mrlsgit/electronic_crouse_design/9013 9014.docx

1、9013 结构：NPN

集电极-发射极电压 25V

集电极-基电压 45V

射极-基极电压 5V

集电极电流 0.5A

耗散功率 0.625W

结温 150℃

特怔频率最小：150MHZ

放大倍数：D64-91 E78-112 F96-135 G122-166 H144-220 I190-300

2、9014 结构：NPN

集电极-发射极电压 45V

集电极-基电压 50V

射极-基极电压 5V

集电极电流 0.1A

耗散功率 0.4W

结温 150℃

特怔频率最小：150MHZ

放大倍数：A60-150 B100-300 C200-600 D400-1000
