mrlsgit/electronic_crouse_design/电路模型.pptx

Ic

Ibe

Vs

R2

R3

rbe

βIbe

R1

## Slide 2

Ic

Ibe

Vs

R6

R4

rbe

βIbe

R5
