mrlsgit/electronic_crouse_design/设计提示.docx

https://zhidao.baidu.com/question/538384263.html
连接中有两个黄色的MIC放大电路，第一种、第二种，完成仿真，将电源电压调整为5V后，实现与3.7V类似的效果，完成实物测试；注意，扬声器不能长时间通直流电，否则会烧掉，因此第一个电路可能要稍微设计一下。MIC在multisim中可以用信号源来替代，用什么样的信号源，需要你们自己测试或者上网多了解一下MIC的真实输出
