mrlsgit/electronic_crouse_design/实验/基本电路2_无直流.docx

原电路：

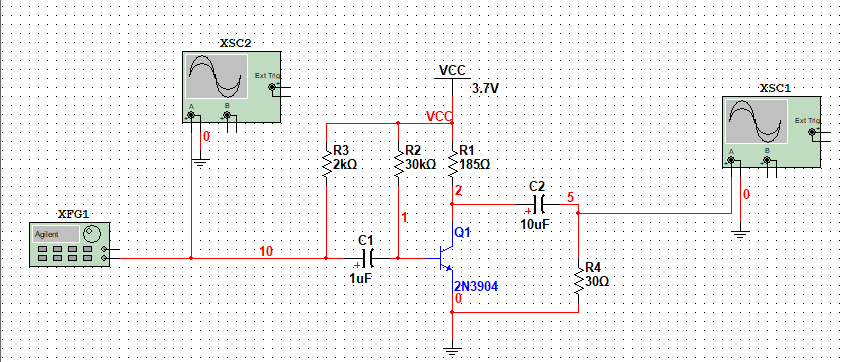
[picture p28: figure]

增压电路：

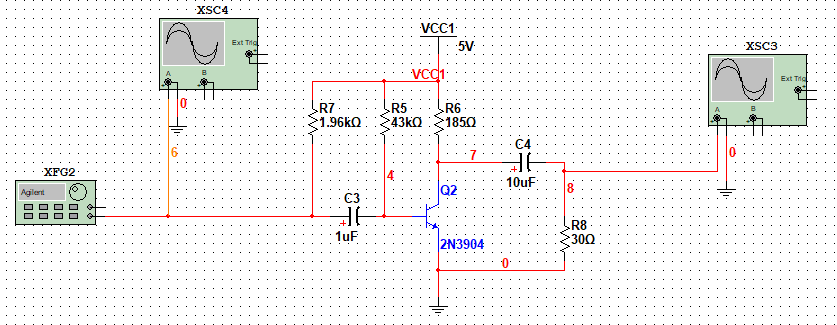
[picture p29: figure]
