mrlsgit/electronic_crouse_design/开发文档/2_见面表部分 - 副本.docx

师生见面情况记录-_1__

见面时间： 见面地点：

学生记录：

学生签名：

指导教师意见：

指导教师签名：

师生见面情况记录-___

见面时间： 见面地点：

学生记录：

学生签名：

指导教师意见：

指导教师签名：

师生见面情况记录-___

见面时间： 见面地点：

学生记录：

学生签名：

指导教师意见：

指导教师签名：

师生见面情况记录-___

见面时间： 见面地点：

学生记录：

学生签名：

指导教师意见：

指导教师签名：
