mrlsgit/electronic_crouse_design/aaa.png

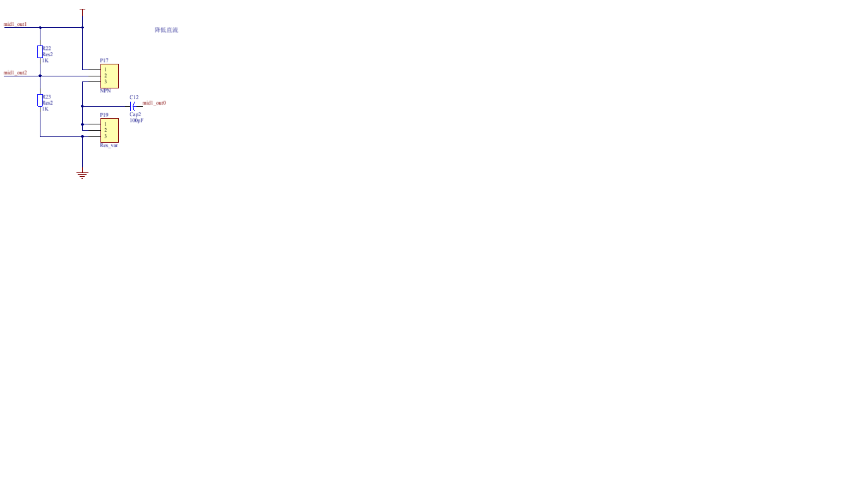
aaa.png
