mrlsgit/electronic_crouse_design/图解法.jpg

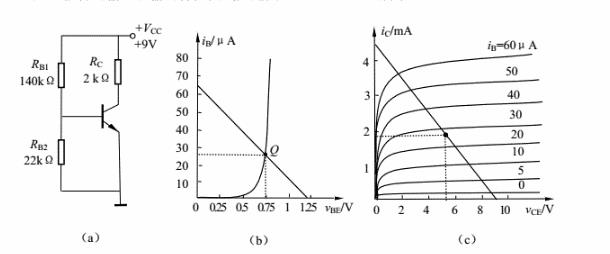
图解法.jpg
