mrlsgit/electronic_crouse_design/放大区.png

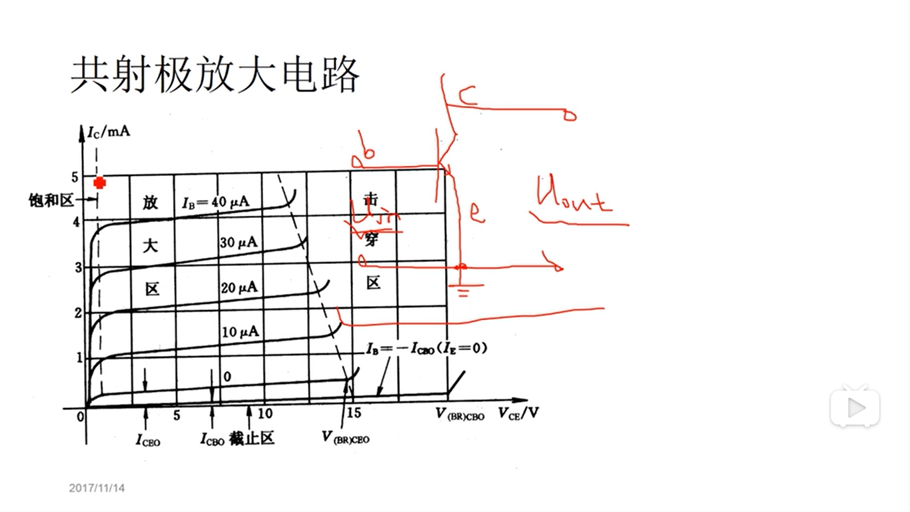
放大区.png
