mrlsgit/electronic_crouse_design/BOM_d31d5e1dcab0406cb8a33961bf945c6c_20181110234616.xlsx

ID | Name | Designator | Footprint | Quantity | Manufacturer Part | Manufacturer | Supplier | Supplier Part | Mounted
1 | 9014C | Q1 | TO-92(TO-92-3) | 1 | 9014C | SEMTECH | LCSC | C118554 | Yes
2 | 1u | C1,C2 | CAP-D3.0XF1.5 | 2 | ? |  |  |  | Yes
3 | 2k | R1,R4 | AXIAL-0.3 | 2 | ? |  |  |  | Yes
4 | 43k | R2 | AXIAL-0.3 | 1 | ? |  |  |  | Yes
5 | 100 | R3 | AXIAL-0.3 | 1 | ? |  |  |  | Yes
6 | 驻极体话筒lib | U1 | 驻极体话筒PCBLIB | 1 | ? |  |  |  | Yes
