mrlsgit/electronic_crouse_design/元器件领用清单-内有两个表格-16级.xlsx

Sheet: 核心元件表
 |  | 班级
 | 元器件 | 型号规格 | 数量 | 备注
1 | IC插座 | 8脚
2 | IC插座 | 14脚
3 | IC插座 | 16脚
4 | IC插座 | 20脚
5 | 集成芯片 | 74LS00 |  | 一定记得配14脚IC插座，不能直接焊在PCB板中
6 | 集成芯片 | 74LS04 |  | 一定记得配14脚IC插座，不能直接焊在PCB板中
7 | 集成芯片 | 74LS08 |  | 一定记得配14脚IC插座，不能直接焊在PCB板中
8 | 集成芯片 | 74LS10 |  | 一定记得配14脚IC插座，不能直接焊在PCB板中
9 | 集成芯片 | 74LS14 |  | 一定记得配14脚IC插座，不能直接焊在PCB板中
10 | 集成芯片 | 74LS20 |  | 一定记得配14脚IC插座，不能直接焊在PCB板中
11 | 集成芯片 | 74LS30 |  | 一定记得配14脚IC插座，不能直接焊在PCB板中
12 | 集成芯片 | 74LS32 |  | 一定记得配14脚IC插座，不能直接焊在PCB板中
13 | 集成芯片 | 74LS74 |  | 一定记得配14脚IC插座，不能直接焊在PCB板中
14 | 集成芯片 | 7447 |  | 一定记得配16脚IC插座，不能直接焊在PCB板中
15 | 集成芯片 | 74121 |  | 一定记得配14脚IC插座，不能直接焊在PCB板中
16 | 集成芯片 | 74123 |  | 一定记得配16脚IC插座，不能直接焊在PCB板中
17 | 集成芯片 | 74LS138 |  | 一定记得配16脚IC插座，不能直接焊在PCB板中
18 | 集成芯片 | 74LS164 |  | 一定记得配14脚IC插座，不能直接焊在PCB板中
19 | 集成芯片 | 74HC192 |  | 一定记得配16脚IC插座，不能直接焊在PCB板中
20 | 集成芯片 | 74HC193 |  | 一定记得配16脚IC插座，不能直接焊在PCB板中
21 | 集成芯片 | 74LS194 |  | 一定记得配16脚IC插座，不能直接焊在PCB板中
22 | 集成芯片 | 74LS373 |  | 一定记得配20脚IC插座，不能直接焊在PCB板中
23 | 集成芯片 | 555 |  | 一定记得配8脚IC插座，不能直接焊在PCB板中，不区分前缀NE、LM
24 | 集成芯片 | CD4013 |  | 一定记得配14脚IC插座，不能直接焊在PCB板中
25 | 集成芯片 | CD4017 |  | 一定记得配16脚IC插座，不能直接焊在PCB板中
26 | 集成芯片 | CD4070 |  | 一定记得配14脚IC插座，不能直接焊在PCB板中
27 | 集成芯片 | CD4543 |  | 一定记得配14脚IC插座，不能直接焊在PCB板中
28 | 集成芯片 | CD4538 |  | 一定记得配16脚IC插座，不能直接焊在PCB板中
29 | 模拟芯片 | LM324 |  | 四运放，一定记得配14脚的IC插座，注意±双电源供电
30 | 模拟芯片 | LM358 |  | 双运放，一定记得配8脚的IC插座，注意±双电源供电
31 | 模拟芯片 | LM741 |  | 单运放，一定记得配8脚的IC插座，注意±双电源供电
32 | 模拟芯片 | LM339 |  | 四比较器，一定记得配14脚IC插座，不能直接焊在PCB板中
33 | 模拟芯片 | LM393 |  | 双比较器，一定记得配8脚的IC插座，可以单电源供电
 |  |  | 备注： | 数量多的元器件只能按班领一些，大家交换使用
 |  |  |  | LS、HC的数字芯片功能上是兼容的，不区分74LS***与74HC***

Sheet: 总表
 |  | 班级
 | 元器件 | 型号规格 | 数量 | 备注
1 | IC插座 | 8脚
2 | IC插座 | 14脚
3 | IC插座 | 16脚
4 | 电容 | 10μF |  | 电解电容，有极性
5 | 电容 | 1μF |  | 电解电容，有极性
6 | 电容 | 0.1μF |  | 标注104
7 | 电容 | 0.01μF |  | 标注103或者10n
8 | LED | 红or绿or黄 |  | Φ3mm直径的LED，引脚间距100mil，颜色随机
9 | 数码管 | 共阳 |  | 两行引脚，水平排列，0.5英寸，教材P350左下角
10 | 电阻 | 10kΩ |  | axial-0.3，尽量把阻值靠近这两个参数
11 | 电阻 | 1kΩ |  | axial-0.3，尽量把阻值靠近这两个参数
12 | 可变电阻 | 100kΩ |  | 3296电位器，外形见教材
13 | 可变电阻 | 10kΩ |  | 3296电位器，外形见教材
14 | 集成芯片 | 74LS00 |  | 一定记得配14脚IC插座，不能直接焊在PCB板中
15 | 集成芯片 | 74LS04 |  | 一定记得配14脚IC插座，不能直接焊在PCB板中
16 | 集成芯片 | 74LS08 |  | 一定记得配14脚IC插座，不能直接焊在PCB板中
17 | 集成芯片 | 74LS10 |  | 一定记得配14脚IC插座，不能直接焊在PCB板中
18 | 集成芯片 | 74LS14 |  | 一定记得配14脚IC插座，不能直接焊在PCB板中
19 | 集成芯片 | 74LS20 |  | 一定记得配14脚IC插座，不能直接焊在PCB板中
20 | 集成芯片 | 74LS30 |  | 一定记得配14脚IC插座，不能直接焊在PCB板中
21 | 集成芯片 | 74LS32 |  | 一定记得配14脚IC插座，不能直接焊在PCB板中
22 | 集成芯片 | 7447 |  | 一定记得配16脚IC插座，不能直接焊在PCB板中
23 | 集成芯片 | 74HC86或CD4070 |  | 一定记得配14脚IC插座，不能直接焊在PCB板中
24 | 集成芯片 | 74121 |  | 一定记得配14脚IC插座，不能直接焊在PCB板中
25 | 集成芯片 | 74123 |  | 一定记得配16脚IC插座，不能直接焊在PCB板中
26 | 集成芯片 | 74LS138 |  | 一定记得配16脚IC插座，不能直接焊在PCB板中
27 | 集成芯片 | 74LS164 |  | 一定记得配14脚IC插座，不能直接焊在PCB板中
28 | 集成芯片 | 74HC192 |  | 一定记得配16脚IC插座，不能直接焊在PCB板中
29 | 集成芯片 | 74LS194 |  | 一定记得配16脚IC插座，不能直接焊在PCB板中
30 | 集成芯片 | 555 |  | 一定记得配8脚IC插座，不能直接焊在PCB板中
31 | 集成芯片 | CD4017 |  | 一定记得配16脚IC插座，不能直接焊在PCB板中
32 | 集成芯片 | CD4543 |  | 一定记得配14脚IC插座，不能直接焊在PCB板中
33 | 集成芯片 | CD4538 |  | 一定记得配16脚IC插座，不能直接焊在PCB板中
34 | 模拟芯片 | LM741 |  | 单运放，一定记得配8脚的IC插座，注意±8V双电源供电
35 | 模拟芯片 | LM393 |  | 双比较器，一定记得配8脚的IC插座，可以单电源供电
36 | NPN三极管 | 9014 |  | 引脚排列ebc，可把中间引脚位置与旁边两只管脚适当错开
37 | PNP三极管 | 8550 |  | 引脚排列ebc，可把中间引脚位置与旁边两只管脚适当错开
38 | 二极管 | 1N4148 |  | 普通的开关二极管
39 | 按键、按钮 | 自复位按钮 |  | 4脚，内部只有一组常开触点，教材P252
40 | 信号源套件 | 555产生Hz级信号 |  | 270kΩ、680kΩ、0.1μF各一只、555一只，8脚插座一只
 |  |  | 备注： | 数量多的元器件只能按班领一些，大家交换使用
 |  |  |  | LS、HC的数字芯片功能上是兼容的，不区分74LS***与74HC***
 |  |  |  | 其他数字芯片的清单前面已经发送
 | 其他元件
