mrlsgit/electronic_crouse_design/(list of files, drawings)

Other design files:
pcb1.PcbDoc
pcb2.PcbDoc
pcb_proj/crouse_desisgn_ver1/circuit1_ver1.SchDoc
pcb_proj/crouse_desisgn_ver1/circuit1_ver2.SchDoc
pcb_proj/crouse_desisgn_ver1/circuit2_ver1.SchDoc
pcb_proj/crouse_desisgn_ver1/circuit2_ver2.SchDoc
pcb_proj/crouse_desisgn_ver1/crouse_desisgn_ver1.PrjPcb
temp/PCB2_other1.PcbDoc
temp/PCB_Project1.PrjPCB
电路/仿真电路1.ms10
电路/仿真电路2.ms10
电路/输出功率放大.ms10
电路/输出去耦合.ms10
电路/频率响应.ms10
电路_multisim14/成品_ver1.ms14
电路_multisim14/成品_ver2.ms14
电路_multisim14/推挽电路_研究.ms14
电路_multisim14/搞头_ver1.ms14
电路_multisim14/曙光_ver1.ms14
电路_multisim14/源电路-研究.ms14
电路_multisim14/电路1_ver2.ms14
电路_multisim14/电路1_研究.ms14
电路_multisim14/电路2_ver1.ms14
电路_multisim14/负载匹配.ms14
电路_multisim14/负载匹配_射极跟随器.ms14
